tomfav/Active-Multifilament-System/3D parts/3mf/Active-Multifilament-System_Orca.3mf

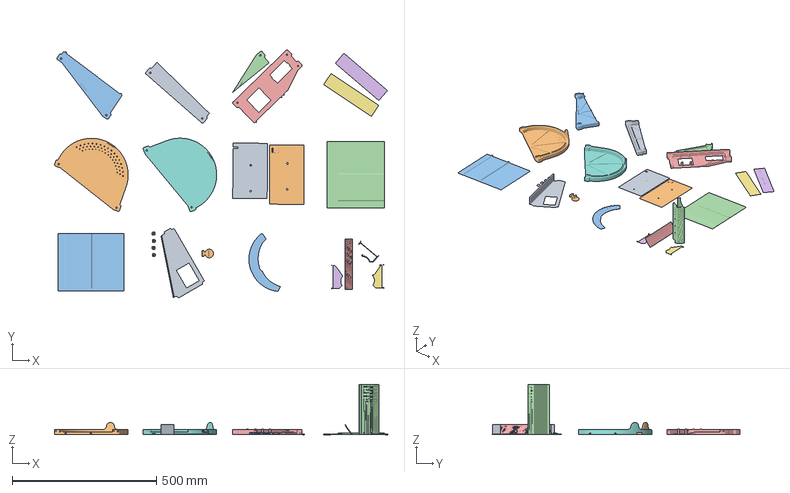
[picture p9: CAD file, 2026-11-03]
3D parts/3mf/Active-Multifilament-System_Orca.3mf
1155.9 x 861.9 x 175.0 mm
Side.stl x 4
Lid_end_cup_right.stl
front.stl x 2
Lid_end_cup_left.stl
Panel_Base_Rear.stl x 2
Panel_Base_Bottom.stl x 2
T-nut x 4
cover.stl
Latch_1
cap.stl
Test2_C1.stl
Test_2_C2.stl
cap_silica1.stl
cap_silica2.stl
