tomfav/Active-Multifilament-System/3D parts/CAD models/Active-Multifilament-System_v1.1.step

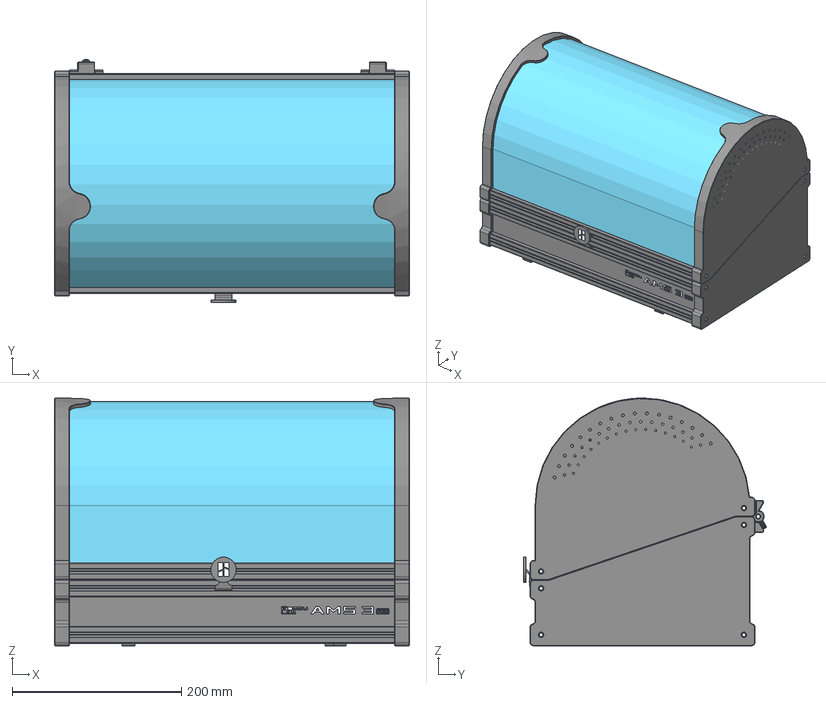
[picture p10: CAD file, 2026-11-03]
3D parts/CAD models/Active-Multifilament-System_v1.1.step
420.0 x 287.9 x 293.2 mm
2020_Base
EndCap_Base_Left
EndCap_Base_Right(Mirror)
94180A361_Tapered Heat-Set Inserts for Plastic
90751A121_18-8 Stainless Steel Socket Head Screws
Hinge_Base_Right(Mirror)
Panel_Base_Rear
Panel_Base_Front
Panel_Base_Bottom
EndCap_Lid_Left
Frame_Lid
Panel_Lid
EndCap_Lid_Right(Mirror)
Hinge_Lid_Right(Mirror)
Hinge_Lid_Left
Latch_Lid
CDR x 2
Printed_Drive_Axle x 2
Hub x 2
Pawl_x3 x 6
Retainer x 2
Axle_Bearing_Printed_###_Bearing_x2_[option] x 2
Axle_Bearing_Printed_###_Bearing_x2_[option] (1) x 2
AS568 Standard size 211 x 4
HF081412 x 2
Steel_Axle x 2
90751A113_NO THREADS_18-8 Stainless Steel Socket Head Screws x 2
90751A113_NO THREADS_18-8 Stainless Steel Socket Head Screws_1 x 2
[a]_Rim_Roller_###_Bearing_x2 x 2
Rim_Roller(Mirror) x 2
Tensioner_Mount_Std x 2
[a]_Tensioner_Arm x 2
688_Bearing_Bushing x 2
Printed_688_Roller_[option] x 2
4668K334_Permanently Lubricated Stainless Steel Ball Bearing x 2
Main body x 2
Release clip x 2
ECAS_Clip_[optional_print] x 2
Spring x 2
M3x4x5_Heat-Set Insert x 2
92125A132_NO THREADS_18-8 Stainless Steel Hex Drive Flat Head Screw x 4
91292A022_NO THREADS_18-8 Stainless Steel Socket Head Screw x 2
93475A210_18-8 Stainless Steel Washer x 2
Tensioner_Mount_Microswitch_[option] x 2
D2F_01FL_D3.BASE x 2
D2F_01FL_D3.ACTUATOR x 2
7804K104_Stainless Steel Ball Bearing x 2
6x3 Magnet x 2
91292A833_18-8 Stainless Steel Socket Head Screw x 4
8x3 Magnet x 2
Printed_Switch_Lever x 2
6x3_Magnet_Holder x 2
Chassis_R_###_Bearing x 2
Chassis_L_###_Bearing(Mirror) x 2
Chassis_Cntr_Spacer x 2
Fil_Encl_Rear_Mnt_L_###_Bearing_[option](Mirror) x 2
Fil_Encl_Frnt_R_[option] x 2
Fil_Encl_Frnt_L_[option] x 2
4668K334_Permanently Lubricated Stainless Steel Ball Bearing_1 x 4
4668K334_Permanently Lubricated Stainless Steel Ball Bearing_2 x 4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
