tomfav/Active-Multifilament-System/3D parts/3mf/2020_Filamentalist_bambu.3mf

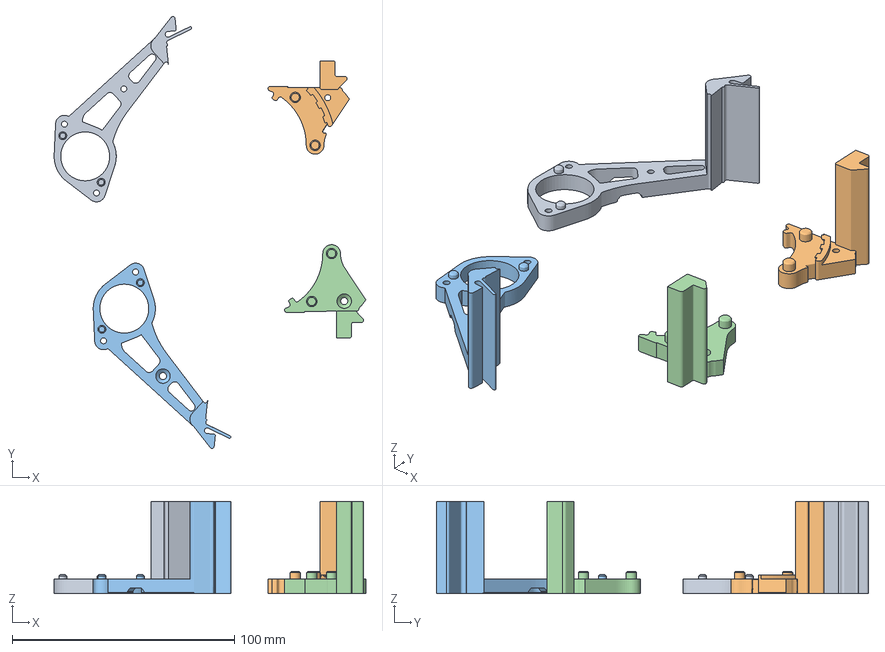
[picture p11: CAD file, 2026-11-03]
3D parts/3mf/2020_Filamentalist_bambu.3mf
140.3 x 194.5 x 41.5 mm
Right_2.stl
Left_2.stl
Right_1.stl
Left_1.stl
