tomfav/Active-Multifilament-System/(list of files, cad)

Other CAD files:
3D parts/3mf/Active-Multifilament-System_Bambu.3mf
3D parts/3mf/2020_Filamentalist.3mf
3D parts/CAD models/Active-Multifilament-System_v1.1.f3z
