tomfav/Active-Multifilament-System/(commit log)

2026-11-03 Revise README for AMS 3 Pro details
    Updated the README to reflect the AMS 3 Pro features and assembly instructions.
2026-11-03 Add humidity and temperature test images
2026-11-03 Add 3MF files for Filamentalist rewinder and update README for clarity and structure
    [2020_Filamentalist.3mf, 2020_Filamentalist_bambu.3mf]
2026-11-03 Update 3MF files for Bambu and Orca models
    [Active-Multifilament-System_Bambu.3mf, Active-Multifilament-System_Orca.3mf]
